TheMadHatt3r/RT-E/Hardware/Main Board Rev1.0b BOM.xlsx

PART on Schematic | Description | Digikey P/N | Qty | Cost / per | Cost 10x |  | Sub Total | Package | Pads | Pad Sum
R2,R4, R7, R8, R11, R14 | RES 4.7k 1% | RHM4.70KCFCT-ND | 6 | 0.01 |  | x10 | 0.06 | 603 | 2 | 12
R5, R6, R12, R13, R15 | RES 10k 1% | RHM10.0KCFCT-ND | 5 | 0.011 |  | x10 | 0.055 | 603 | 2 | 10
R9, R10 | RES 10k .1% TC=10ppm | 985-1381-1-ND | 2 | 0.76 |  | x1 | 1.52 | 603 | 2 | 4 | 8.3
 | RES 56k 1% | RMCF0603FT56K0CT-ND | 1 | 0.025 | 0.1 | x10 | 0.025 | 603 | 2 | 2 | 4.7 | 0.6238437545 | 0.6011534331
R16, R17, R19, R20, R21 | RES 1k 1% |  | 5 |  |  |  |  |  |  |  | 59
R1 | RES 1.0 1% | 311-1.00FRCT-ND | 1 | 0.032 |  | x10 | 0.032 | 1206 | 2 | 2
R18 | RES 200k | 311-200KGRCT-ND | 1 | 0.011 |  | x10 | 0.011 | 603 | 2 | 2
LED2 | LED GREEN | 754-1121-1-ND | 1 | 0.117 |  | x10 | 0.117 | 603 | 2 | 2
LED1 | LED Yellow | 475-1196-1-ND | 1 | 0.143 |  | x10 | 0.143 | 603 | 2 | 2 |  |  | L | W
C5, C6, C9, C10, C11, C12 | CAP 10nF 50V 10% | 1276-1009-1-ND | 6 | 0.018 |  | x10 | 0.108 | 603 | 2 | 12 |  | SOD-323 | 2.5 | 1.3 | 0.09842519685 | 0.05118110236
C2, C7, C8, C13, C14, C15, C16 | CAP 100nF 50V 10% | 1276-1936-1-ND | 7 | 0.02 |  | x10 | 0.14 | 603 | 2 | 14 |  | SOD-123 | 3.8 | 1.8 | 0.1496062992 | 0.07086614173
 | CAP 330uF 50V | 493-1343-ND |  | 0.48 | 0.34 | x10 | 0 | TH-5MM | 0 | 0 |  | SMA | 5.2 | 2.6 | 0.2047244094 | 0.1023622047
 | CAP 330uF 10V | 1189-2177-ND |  | 0.35 | 0.24 |  | 0 | TH-2.5MM
T1 | BJT (BC846B) 200x 30V | 568-1632-6-ND | 1 | 0.14 |  |  | 0.14 |  | 3 | 3
SMPS-5V | 5V SMPS | 945-1037-ND | 1 | 6.81 |  |  | 6.81 | TH | 0 | 0
 | Schottky 40V 0.5A | DB2J40700LCT-ND |  | 0.41 | 0.3 |  | 0 | SOD-323 | 2 | 0 | 4095 | 0.8058608059
D2 | TVS 28/31 | SMAJ28CALFCT-ND | 1 | 0.47 |  |  | 0.47 | SMA | 2 | 2 | 3300
D4, D5, D7, D6, D8 | 5.1V Zener | MM3Z5V1ST1GOSCT-ND | 5 | 0.13 |  | x10 | 0.65 | SOD-323 | 2 | 10
U1 | 5-> 3.3 V level shifter | 568-4215-1-ND | 1 | 0.78 |  | x1 | 0.78 | SOIC-8 | 8 | 8
SW-MM1, SW-HH1 | PUSHBUTTON - 6MM | CKN9112CT-ND | 2 | 0.2 |  | x10 | 0.4 | 6MM SMD | 4 | 8
UC (2 long sides) | Headers-F-14 | S7047-ND | 2 | 0.98 |  | x10 | 1.96 | TH | 0 | 0
TB-EXP0,TB-EXP1, TB-LCD, UC(short side) | Headers-F-5 | S7038-ND | 5 | 0.5 |  | x10 | 2.5 | TH | 0 | 0
FLOW1, FLOW2, I2C | JST-5 | 455-1707-ND | 3 | 0.26 |  | x10 | 0.78 | TH | 0 | 0
SERIAL, RESET,SPEED,LIGHT1,GPIO1,PWR | JST-2 | 455-1704-ND | 6 | 0.15 |  | x10 | 0.9 | TH | 0 | 0
SD | SD Card Slot | A101492CT-ND | 1 | 3.44 |  | 1x | 3.44 | SMD | 9 | 9
 | Comparator | ADCMP356YKSZ-REEL7CT-ND |  | 0.93 | 0.82 |  |  | SMD
BAT | BAT 3V 2032 | P657-ND | 1 | 1.06 |  | 1.06 | 1.06 | SMD | 2 | 2
 |  | Component Count | 65 |  |  |  |  |  | Pads | 104
