TheMadHatt3r/RT-E/Hardware/RT-E MainBoard Rev 1b Schematic Preliminary.pdf

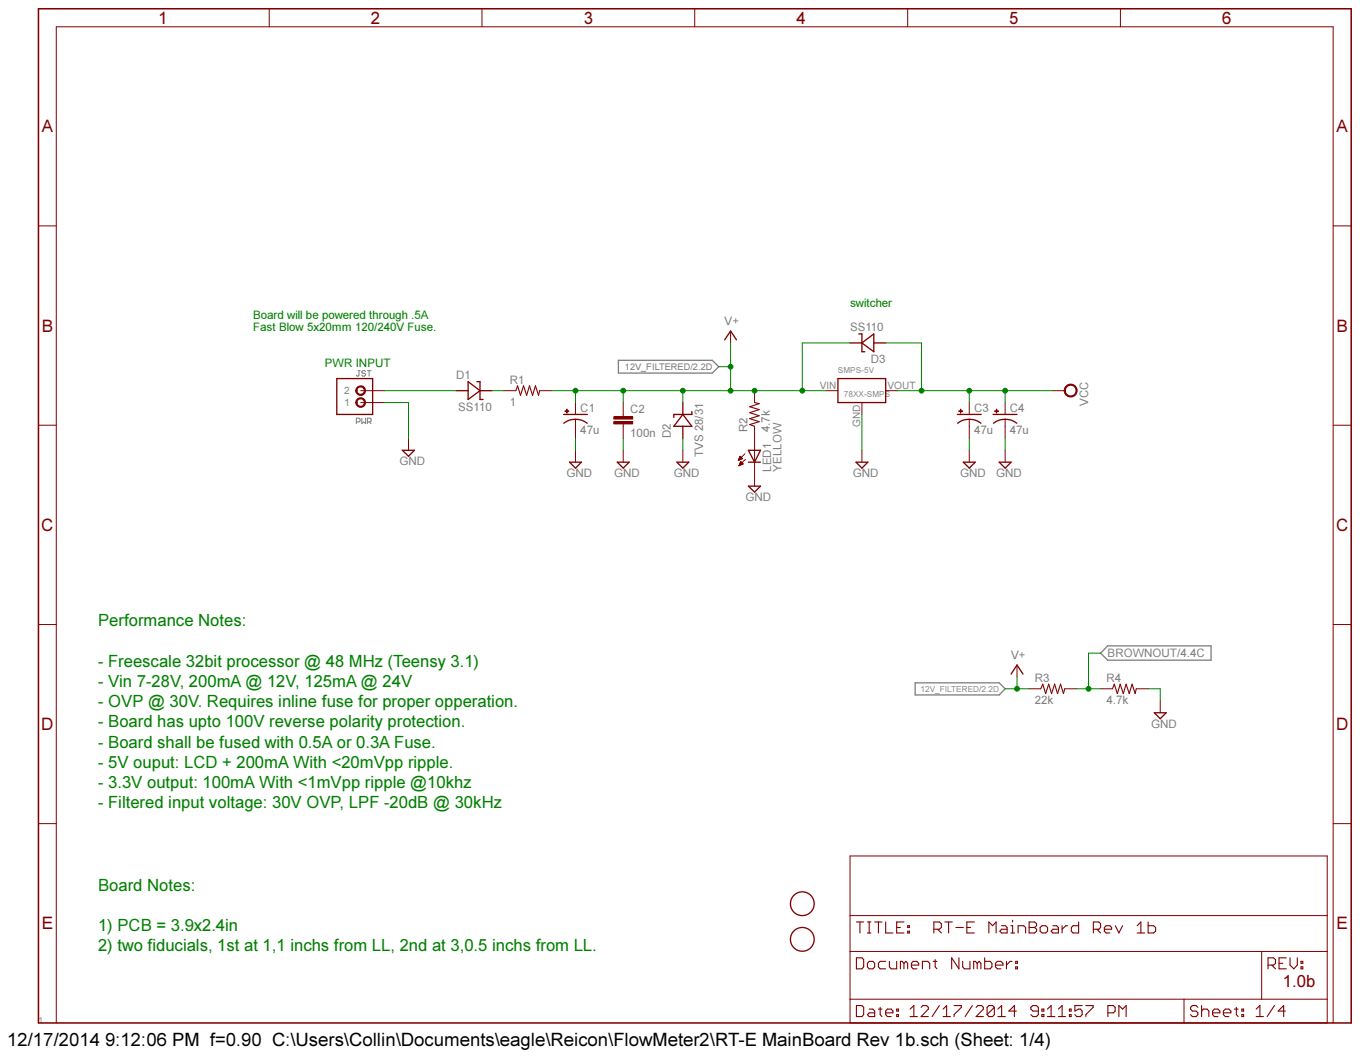
[picture p1: page 1]

Board will be powered through .5A
Fast Blow 5x20mm 120/240V Fuse.

- Freescale 32bit processor @ 48 MHz (Teensy 3.1)
- Vin 7-28V, 200mA @ 12V, 125mA @ 24V
- OVP @ 30V. Requires inline fuse for proper opperation.
- Board has upto 100V reverse polarity protection.
- Board shall be fused with 0.5A or 0.3A Fuse.
- 5V ouput: LCD + 200mA With <20mVpp ripple.
- 3.3V output: 100mA With <1mVpp ripple @10khz
- Filtered input voltage: 30V OVP, LPF -20dB @ 30kHz

1) PCB = 3.9x2.4in
2) two fiducials, 1st at 1,1 inchs from LL, 2nd at 3,0.5 inchs from LL.

12/17/2014 9:12:06 PM f=0.90 C:\Users\Collin\Documents\eagle\Reicon\FlowMeter2\RT-E MainBoard Rev 1b.sch (Sheet: 1/4)

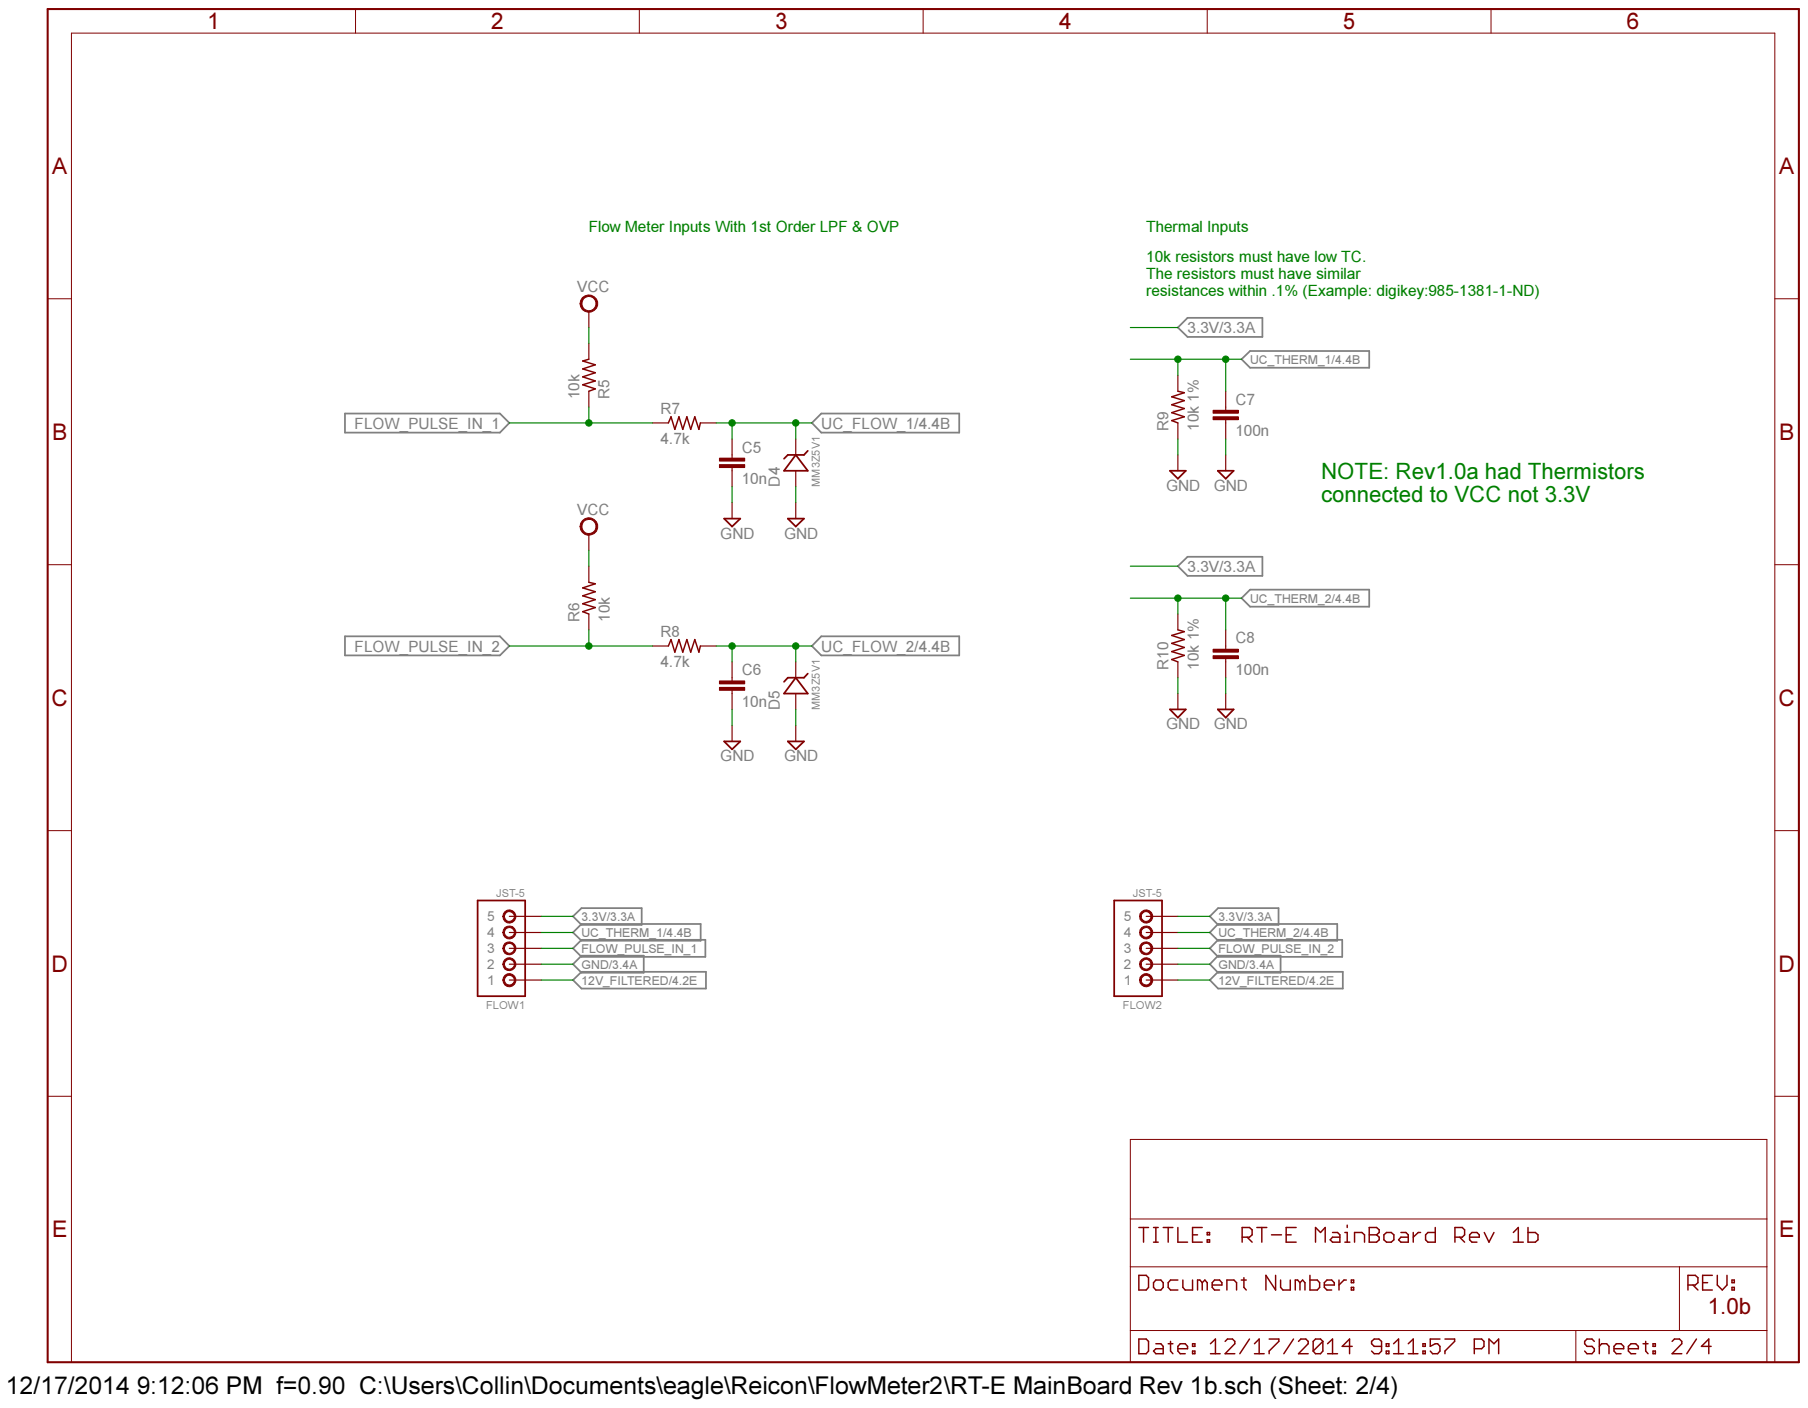
[picture p2: page 2]

10k resistors must have low TC.
The resistors must have similar
resistances within .1% (Example: digikey:985-1381-1-ND)

NOTE: Rev1.0a had Thermistors
connected to VCC not 3.3V

12/17/2014 9:12:06 PM f=0.90 C:\Users\Collin\Documents\eagle\Reicon\FlowMeter2\RT-E MainBoard Rev 1b.sch (Sheet: 2/4)

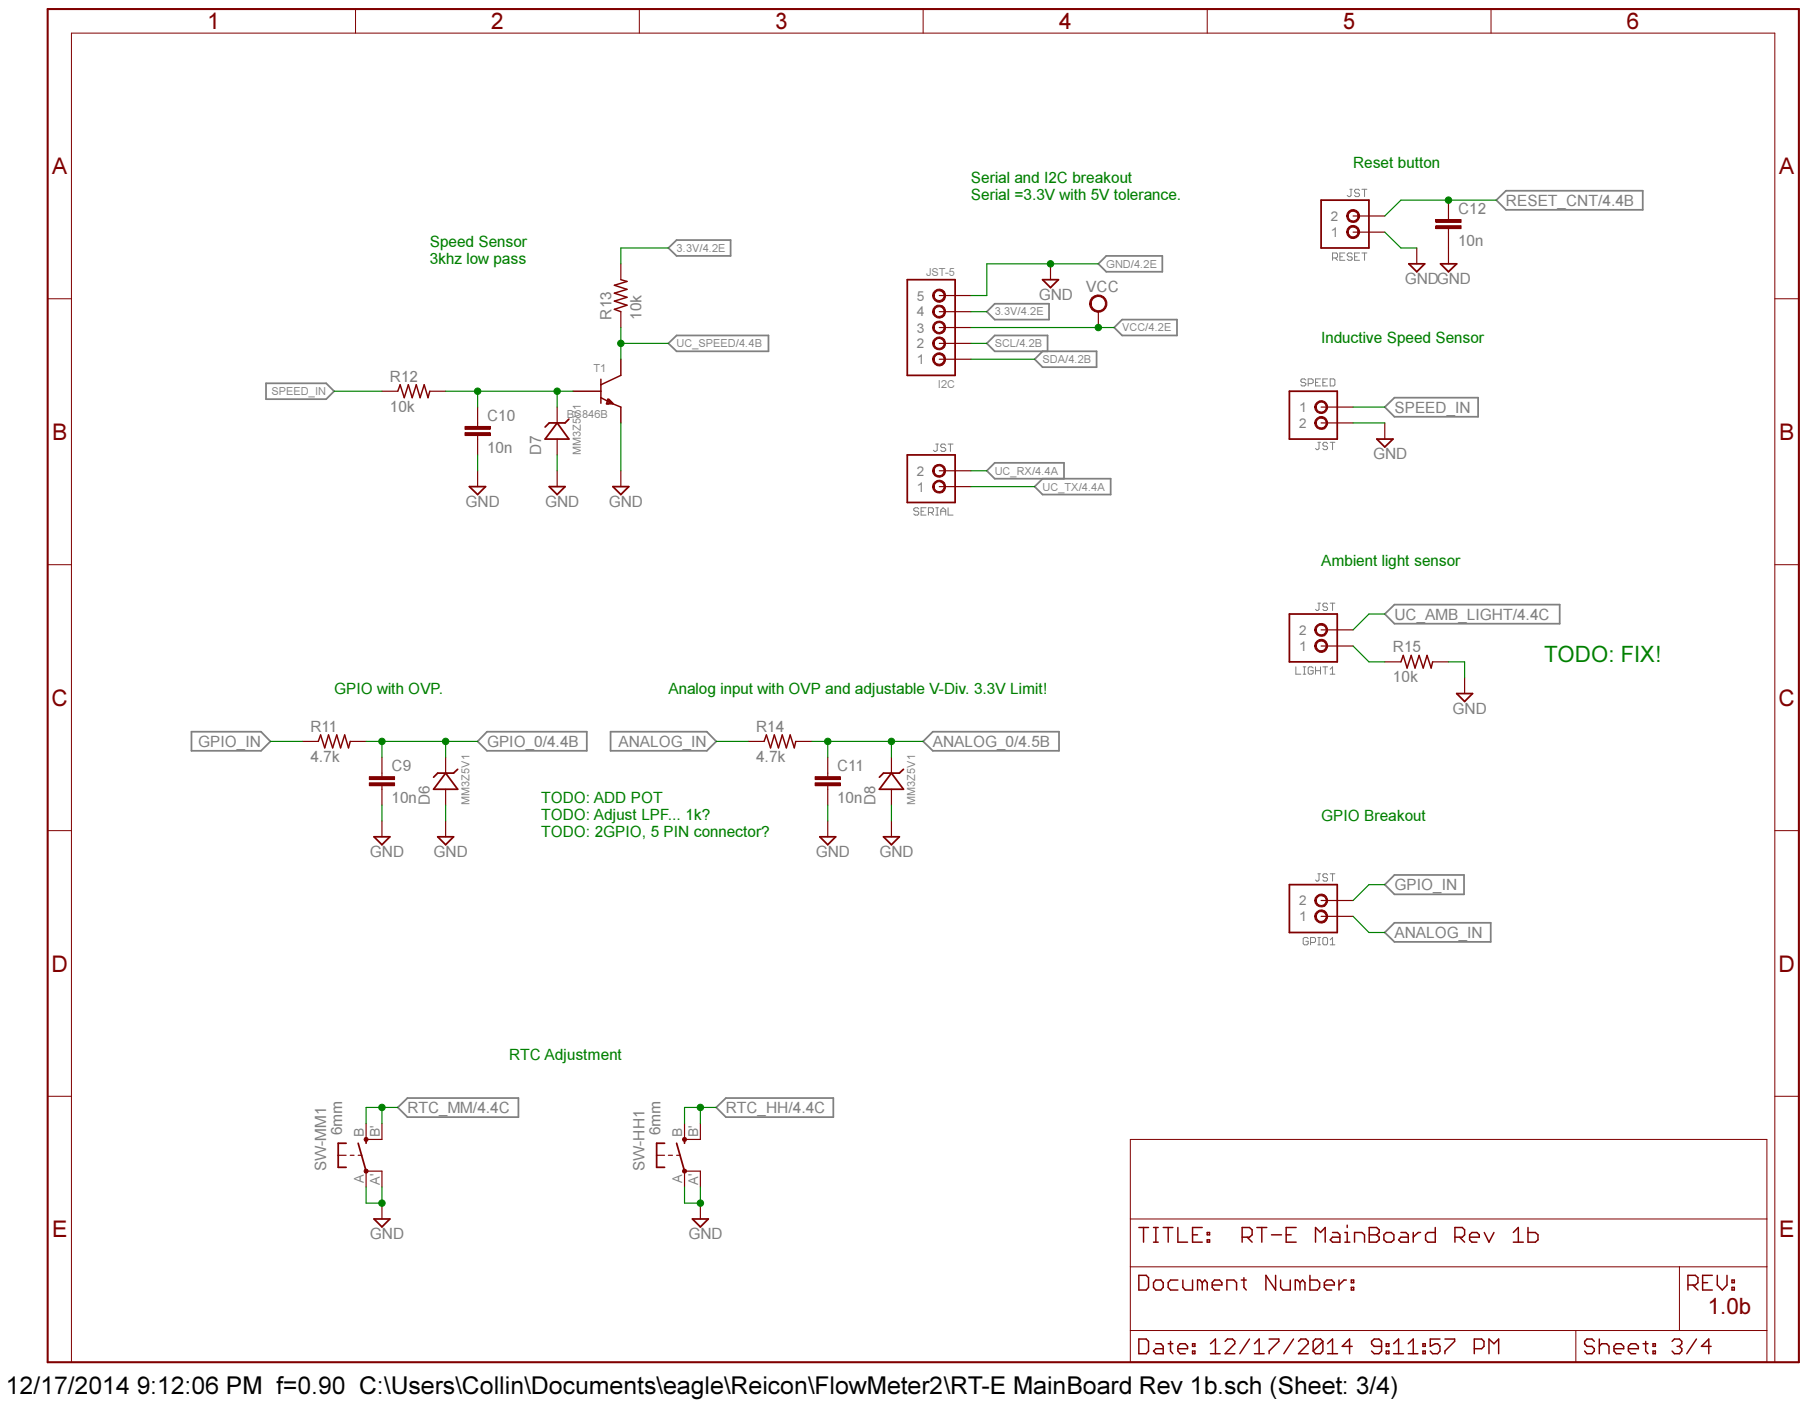
[picture p3: page 3]

12/17/2014 9:12:06 PM f=0.90 C:\Users\Collin\Documents\eagle\Reicon\FlowMeter2\RT-E MainBoard Rev 1b.sch (Sheet: 3/4)

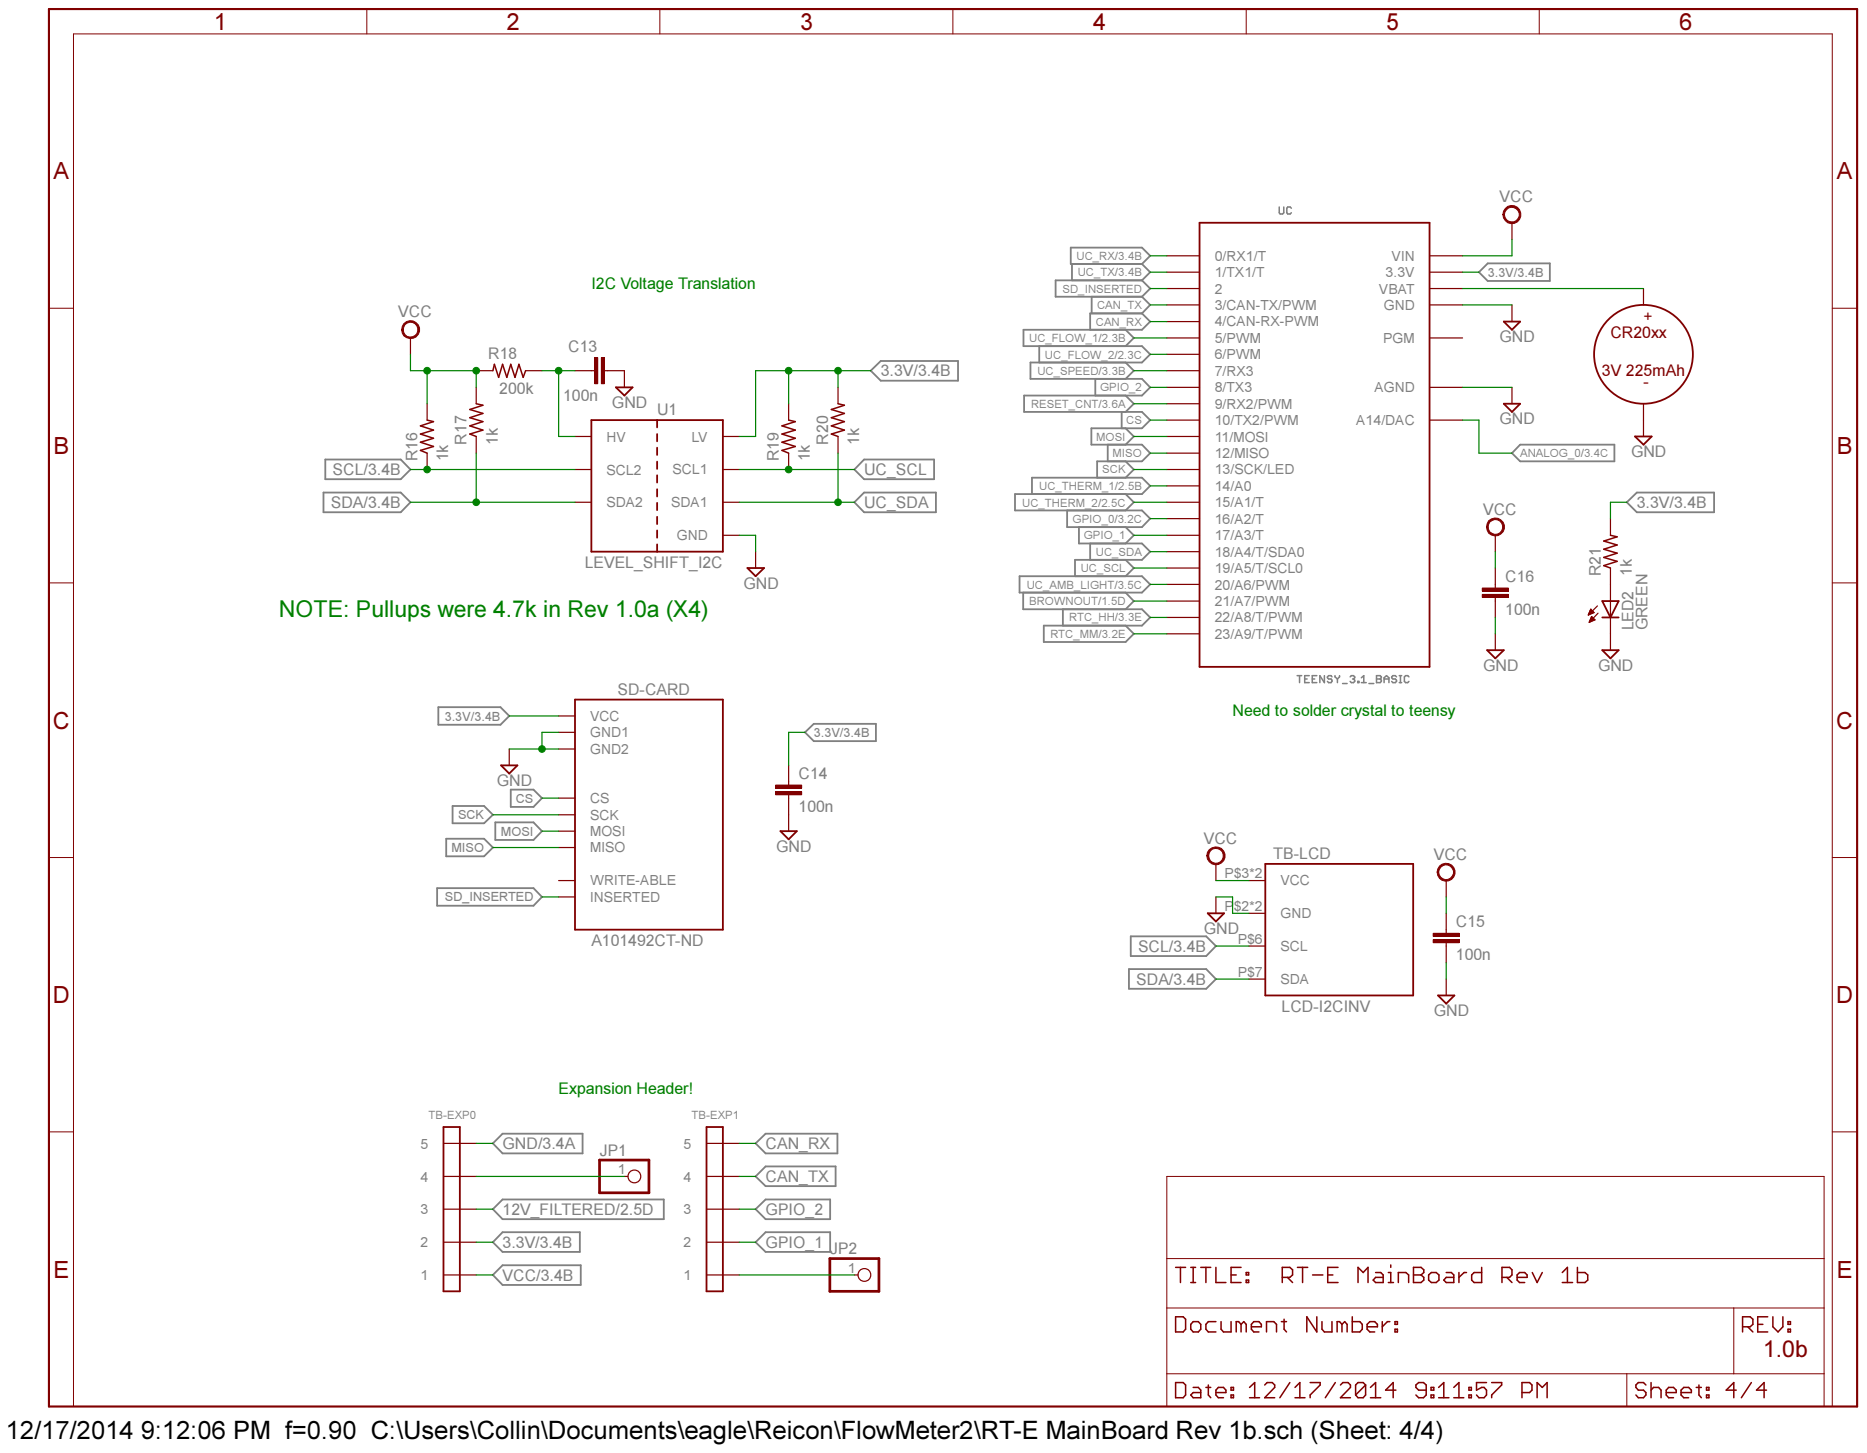
[picture p4: page 4]

NOTE: Pullups were 4.7k in Rev 1.0a (X4)

Need to solder crystal to teensy

12/17/2014 9:12:06 PM f=0.90 C:\Users\Collin\Documents\eagle\Reicon\FlowMeter2\RT-E MainBoard Rev 1b.sch (Sheet: 4/4)
