TheMadHatt3r/RT-E/Hardware/Eagle/Rev1b/RT-E MainBoard Rev 1b.brd

## EAGLE design Hardware/Eagle/Rev1b/RT-E MainBoard Rev 1b.brd (2017-10-30)

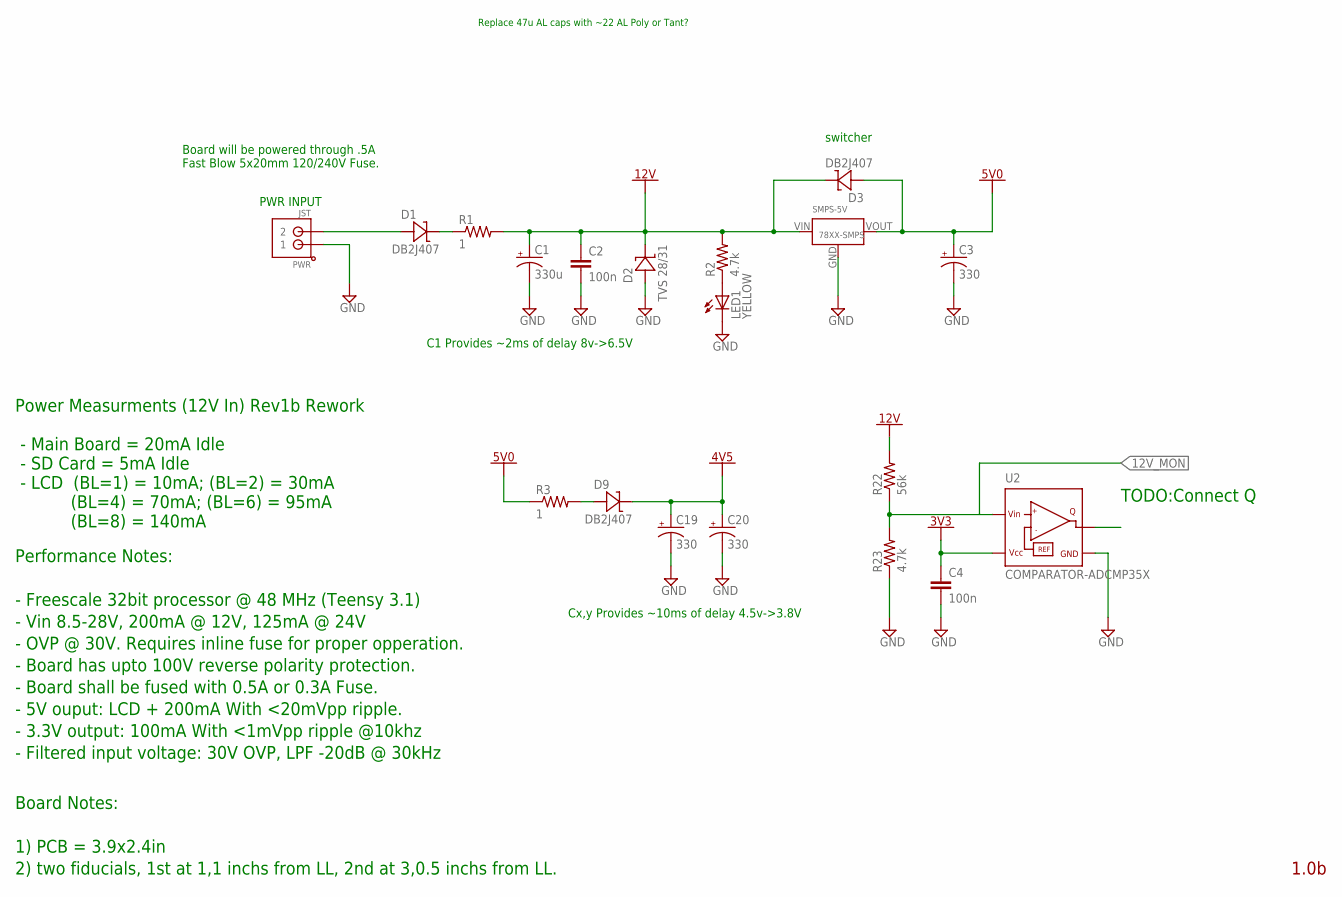
[picture p5: schematic RT-E MainBoard Rev 1b.sch, sheet 1, Power]

Parts:
C1: 330u; E5-10,5
C2, C4: 100n; C0603K
C3, C19, C20: 330; E2,5-7
D1, D3, D9: DB2J407; SOD323R_INFINEON
D2: TVS 28/31; DO-214AC(SMA)
LED1: YELLOW; CHIP-LED0603
PWR: JST; JST_B2B-PH_HEADER
R1, R3: 1; R1206
R2, R23: 4.7k; R0603
R22: 56k; R0603
SMPS-5V: 78XX-SMPS
U2: COMPARATOR-ADCMP35X; SC70-4L

Connections:
3V3: C4.1, C19.+, C20.+, D9.C, U2.5 (VCC); also elsewhere on the board
5V0: C3.+, D3.A, R3.1, SMPS-5V.VOUT; also elsewhere on the board
12V: C1.+, C2.1, D2.P$1, D3.C, R1.2, R2.2, R22.2, SMPS-5V.VIN; also elsewhere on the board
GND: C1.-, C2.2, C3.-, C4.2, C19.-, C20.-, D2.P$2, LED1.C, PWR.P1 (1), R23.1, SMPS-5V.GND, U2.3 (GND); also elsewhere on the board
unnamed: D1.C, R1.1
unnamed: LED1.A, R2.1
unnamed: R22.1, R23.2, U2.1 (VIN)
unnamed: D9.A, R3.2
unnamed: D1.A, PWR.P2 (2)

Notes on the sheet:
Board will be powered through .5A Fast Blow 5x20mm 120/240V Fuse.
switcher
Board Notes: 1) PCB = 3.9x2.4in 2) two fiducials, 1st at 1,1 inchs from LL, 2nd at 3,0.5 inchs from LL.
PWR INPUT
1.0b
Performance Notes: - Freescale 32bit processor @ 48 MHz (Teensy 3.1) - Vin 8.5-28V, 200mA @ 12V, 125mA @ 24V - OVP @ 30V. Requires inline fuse for proper opperation. - Board has upto 100V reverse polarity protection. - Board shall be fused with 0.5A or 0.3A Fuse. - 5V ouput: LCD + 200mA With <20mVp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
Power Measurments (12V In) Rev1b Rework - Main Board = 20mA Idle - SD Card = 5mA Idle - LCD (BL=1) = 10mA; (BL=2) = 30mA (BL=4) = 70mA; (BL=6) = 95mA (BL=8) = 140mA
Replace 47u AL caps with ~22 AL Poly or Tant?
C1 Provides ~2ms of delay 8v->6.5V
TODO:Connect Q
Cx,y Provides ~10ms of delay 4.5v->3.8V

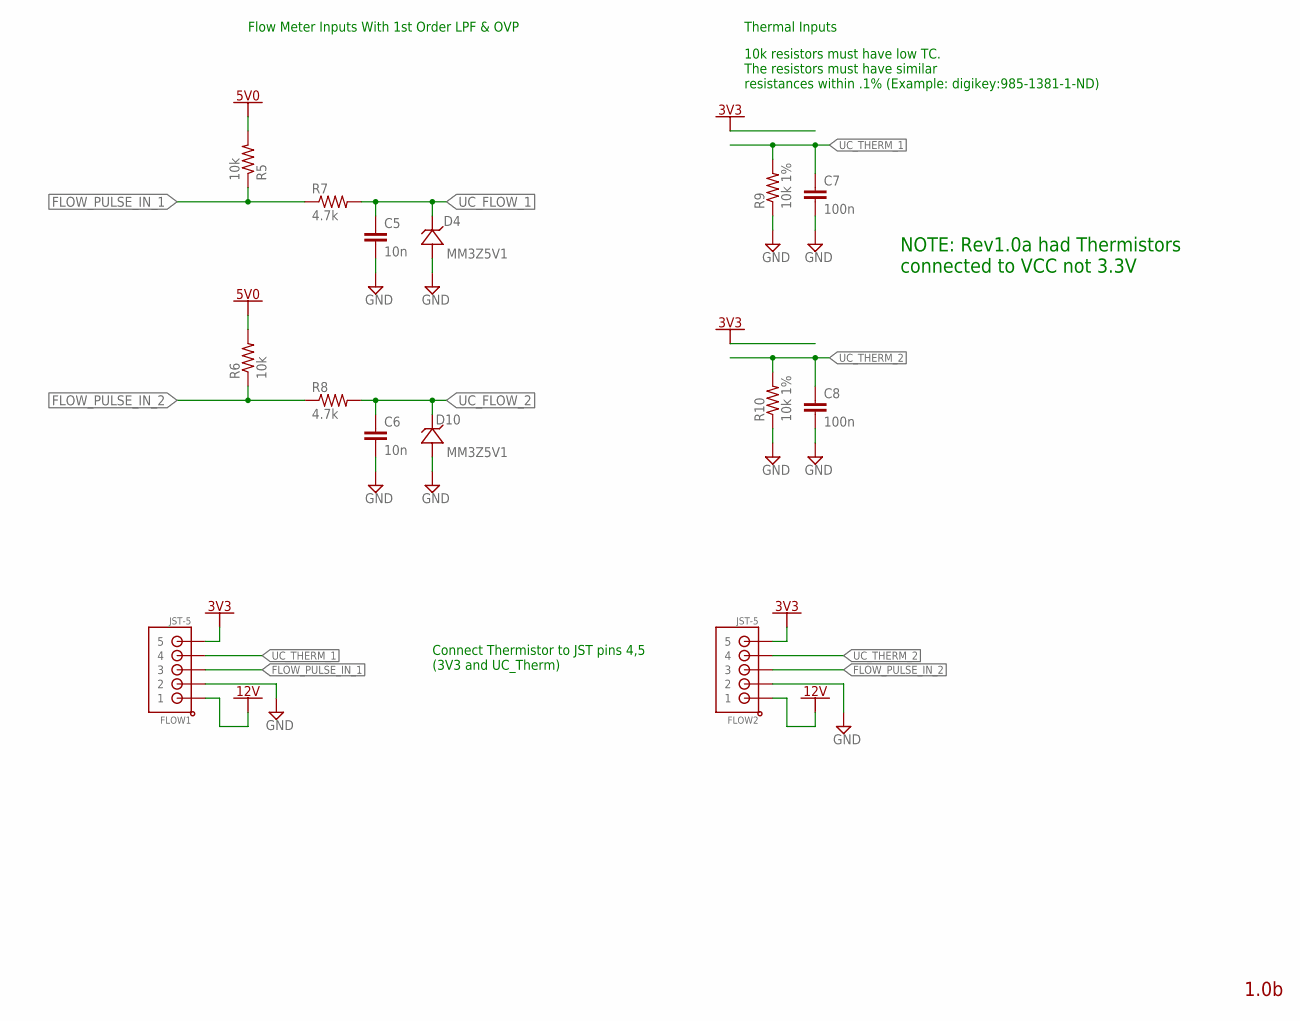
[picture p6: schematic RT-E MainBoard Rev 1b.sch, sheet 2, Flow Inputs]

Parts:
C5, C6: 10n; C0603K
C7, C8: 100n; C0603K
D4, D10: MM3Z5V1; SOD323R_INFINEON
FLOW1, FLOW2: JST-5; JST_B5B-PH_HEADER
R5, R6: 10k; R0603
R7, R8: 4.7k; R0603
R9, R10: 10k 1%; R0603

Connections:
3V3: FLOW1.P5 (5), FLOW2.P5 (5); also elsewhere on the board
5V0: R5.2, R6.2; also elsewhere on the board
12V: FLOW1.P1 (1), FLOW2.P1 (1); also elsewhere on the board
FLOW_PULSE_IN_1: FLOW1.P3 (3), R5.1, R7.1
FLOW_PULSE_IN_2: FLOW2.P3 (3), R6.1, R8.1
GND: C5.2, C6.2, C7.2, C8.2, D4.A, D10.A, FLOW1.P2 (2), FLOW2.P2 (2), R9.1, R10.1; also elsewhere on the board
UC_FLOW_1: C5.1, D4.C, R7.2; also elsewhere on the board
UC_FLOW_2: C6.1, D10.C, R8.2; also elsewhere on the board
UC_THERM_1: C7.1, FLOW1.P4 (4), R9.2; also elsewhere on the board
UC_THERM_2: C8.1, FLOW2.P4 (4), R10.2; also elsewhere on the board

Notes on the sheet:
Flow Meter Inputs With 1st Order LPF & OVP
Thermal Inputs
10k resistors must have low TC. The resistors must have similar resistances within .1% (Example: digikey:985-1381-1-ND)
1.0b
NOTE: Rev1.0a had Thermistors connected to VCC not 3.3V
Connect Thermistor to JST pins 4,5 (3V3 and UC_Therm)

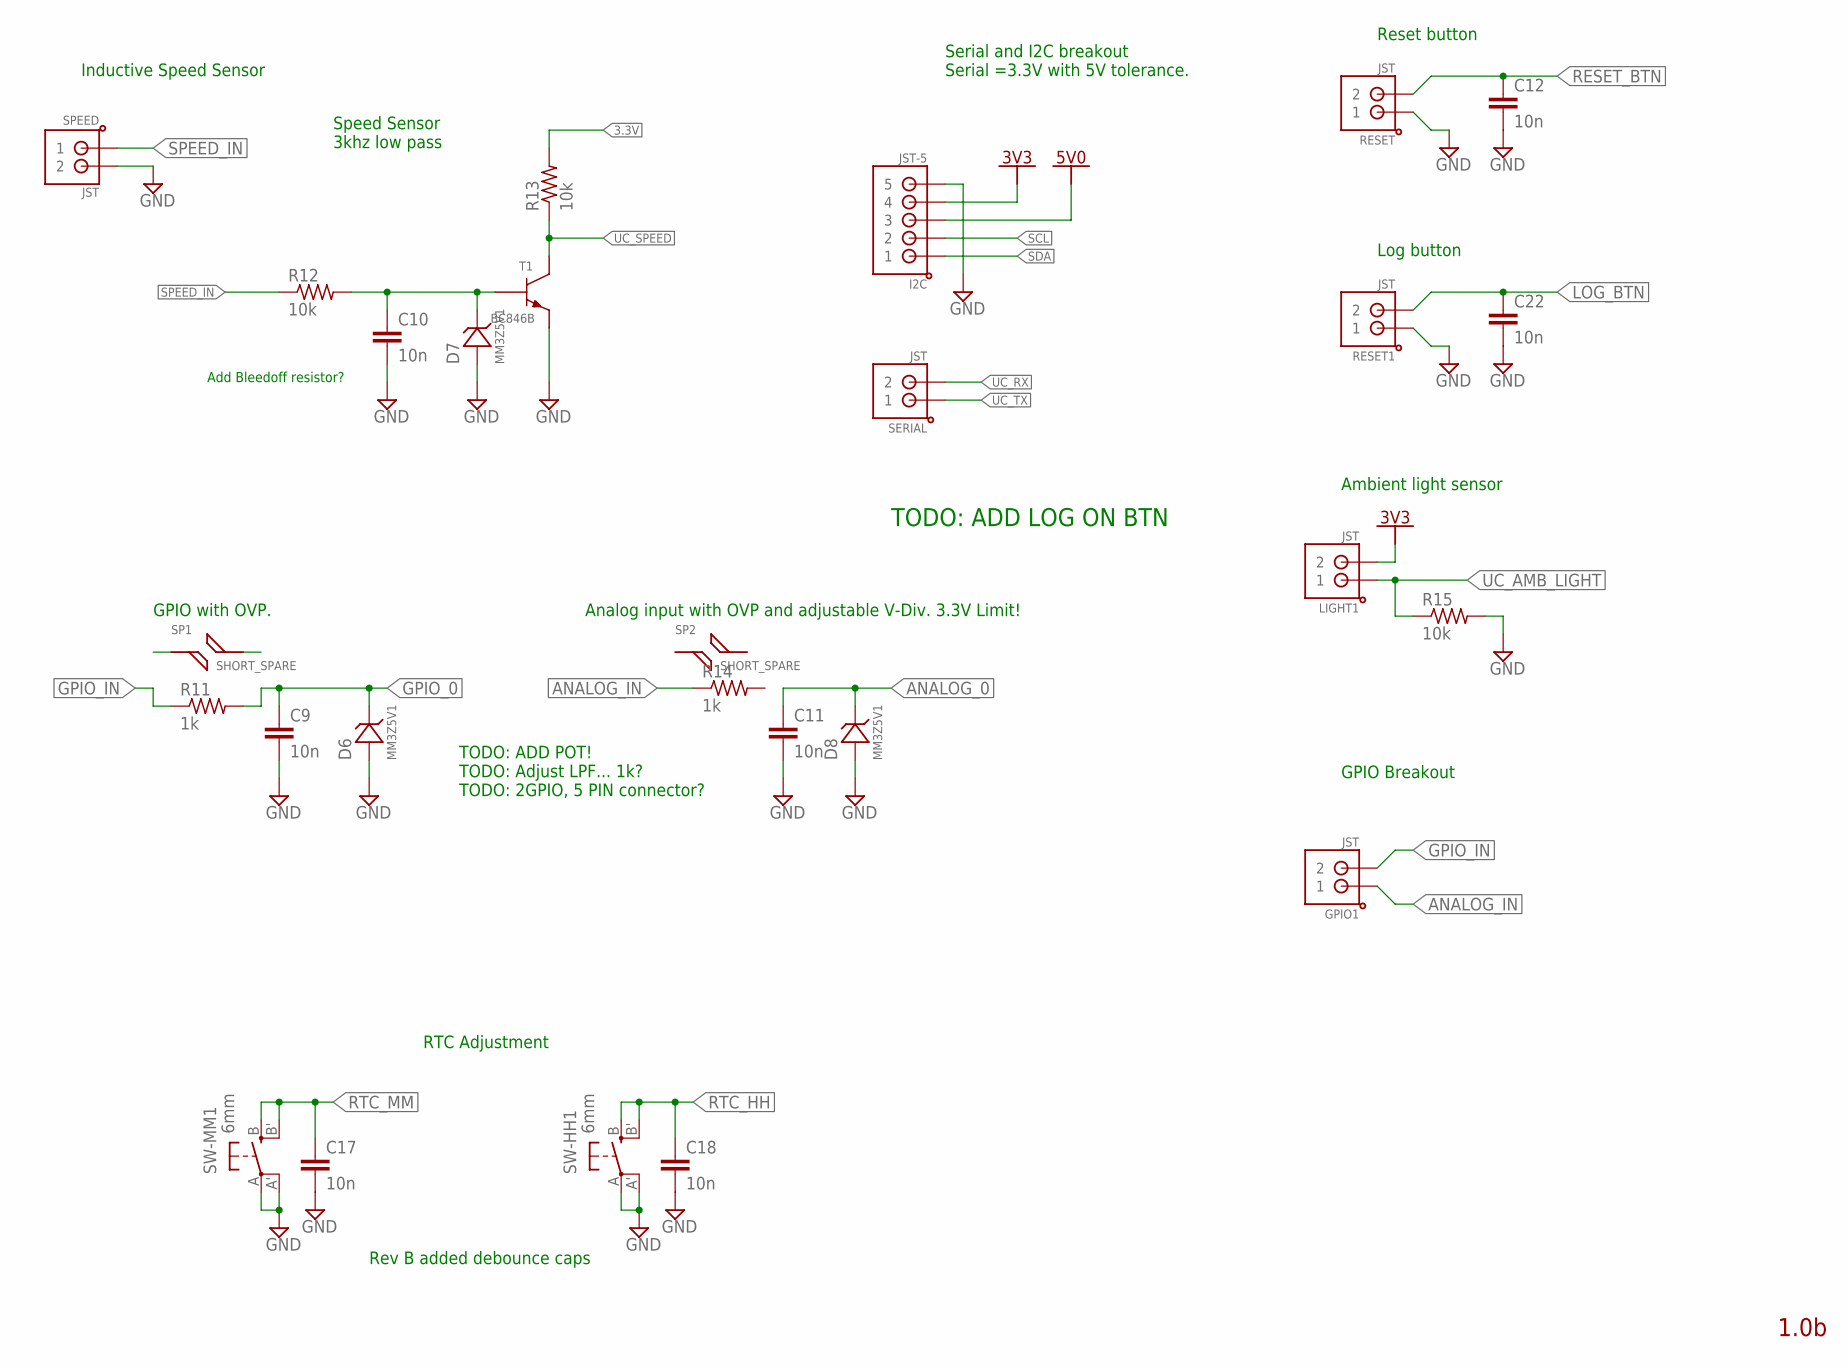
[picture p7: schematic RT-E MainBoard Rev 1b.sch, sheet 3, Other Sensors]

Parts:
C9, C10, C11, C12, C17, C18, C22: 10n; C0603K
D6, D7, D8: MM3Z5V1; SOD323-W
GPIO1: JST; JST_B2B-PH_HEADER
I2C: JST-5; JST_B5B-PH_HEADER
LIGHT1: JST; JST_B2B-PH_HEADER
R11, R14: 1k; R0603
R12, R13, R15: 10k; R0603
RESET, RESET1: JST; JST_B2B-PH_HEADER
SERIAL: JST; JST_B2B-PH_HEADER
SP1, SP2: SHORT_SPARE; SHORT_0603
SPEED: JST; JST_B2B-PH_HEADER
SW-HH1: 6mm; EVQ-Q2
SW-MM1: 6mm; EVQ-Q2
T1: BC846B; BJT-BC846

Connections:
3.3V: R13.2; also elsewhere on the board
3V3: I2C.P4 (4), LIGHT1.P2 (2); also elsewhere on the board
5V0: I2C.P3 (3); also elsewhere on the board
ANALOG_0: C11.1, D8.C; also elsewhere on the board
ANALOG_IN: GPIO1.P1 (1), R14.1
GND: C9.2, C10.2, C11.2, C12.2, C17.2, C18.2, C22.2, D6.A, D7.A, D8.A, I2C.P5 (5), R15.2, RESET.P1 (1), RESET1.P1 (1), SPEED.P2 (2), SW-HH1.A, SW-HH1.A' (P1), SW-MM1.A, SW-MM1.A' (P1), T1.E; also elsewhere on the board
GPIO_0: C9.1, D6.C, R11.2; also elsewhere on the board
GPIO_IN: GPIO1.P2 (2), R11.1
LOG_BTN: C22.1, RESET1.P2 (2); also elsewhere on the board
unnamed: C10.1, D7.C, R12.2, T1.B
RESET_BTN: C12.1, RESET.P2 (2); also elsewhere on the board
RTC_HH: C18.1, SW-HH1.B (S), SW-HH1.B' (S1); also elsewhere on the board
RTC_MM: C17.1, SW-MM1.B (S), SW-MM1.B' (S1); also elsewhere on the board
SCL: I2C.P2 (2); also elsewhere on the board
SDA: I2C.P1 (1); also elsewhere on the board
SPEED_IN: R12.1, SPEED.P1 (1)
UC_AMB_LIGHT: LIGHT1.P1 (1), R15.1; also elsewhere on the board
UC_RX: SERIAL.P2 (2); also elsewhere on the board
UC_SPEED: R13.1, T1.C; also elsewhere on the board
UC_TX: SERIAL.P1 (1); also elsewhere on the board

Notes on the sheet:
Speed Sensor 3khz low pass
Reset button
RTC Adjustment
GPIO with OVP.
Analog input with OVP and adjustable V-Div. 3.3V Limit!
TODO: ADD POT! TODO: Adjust LPF... 1k? TODO: 2GPIO, 5 PIN connector?
Serial and I2C breakout Serial =3.3V with 5V tolerance.
GPIO Breakout
Ambient light sensor
Inductive Speed Sensor
1.0b
Rev B added debounce caps
Add Bleedoff resistor?
TODO: ADD LOG ON BTN
Log button

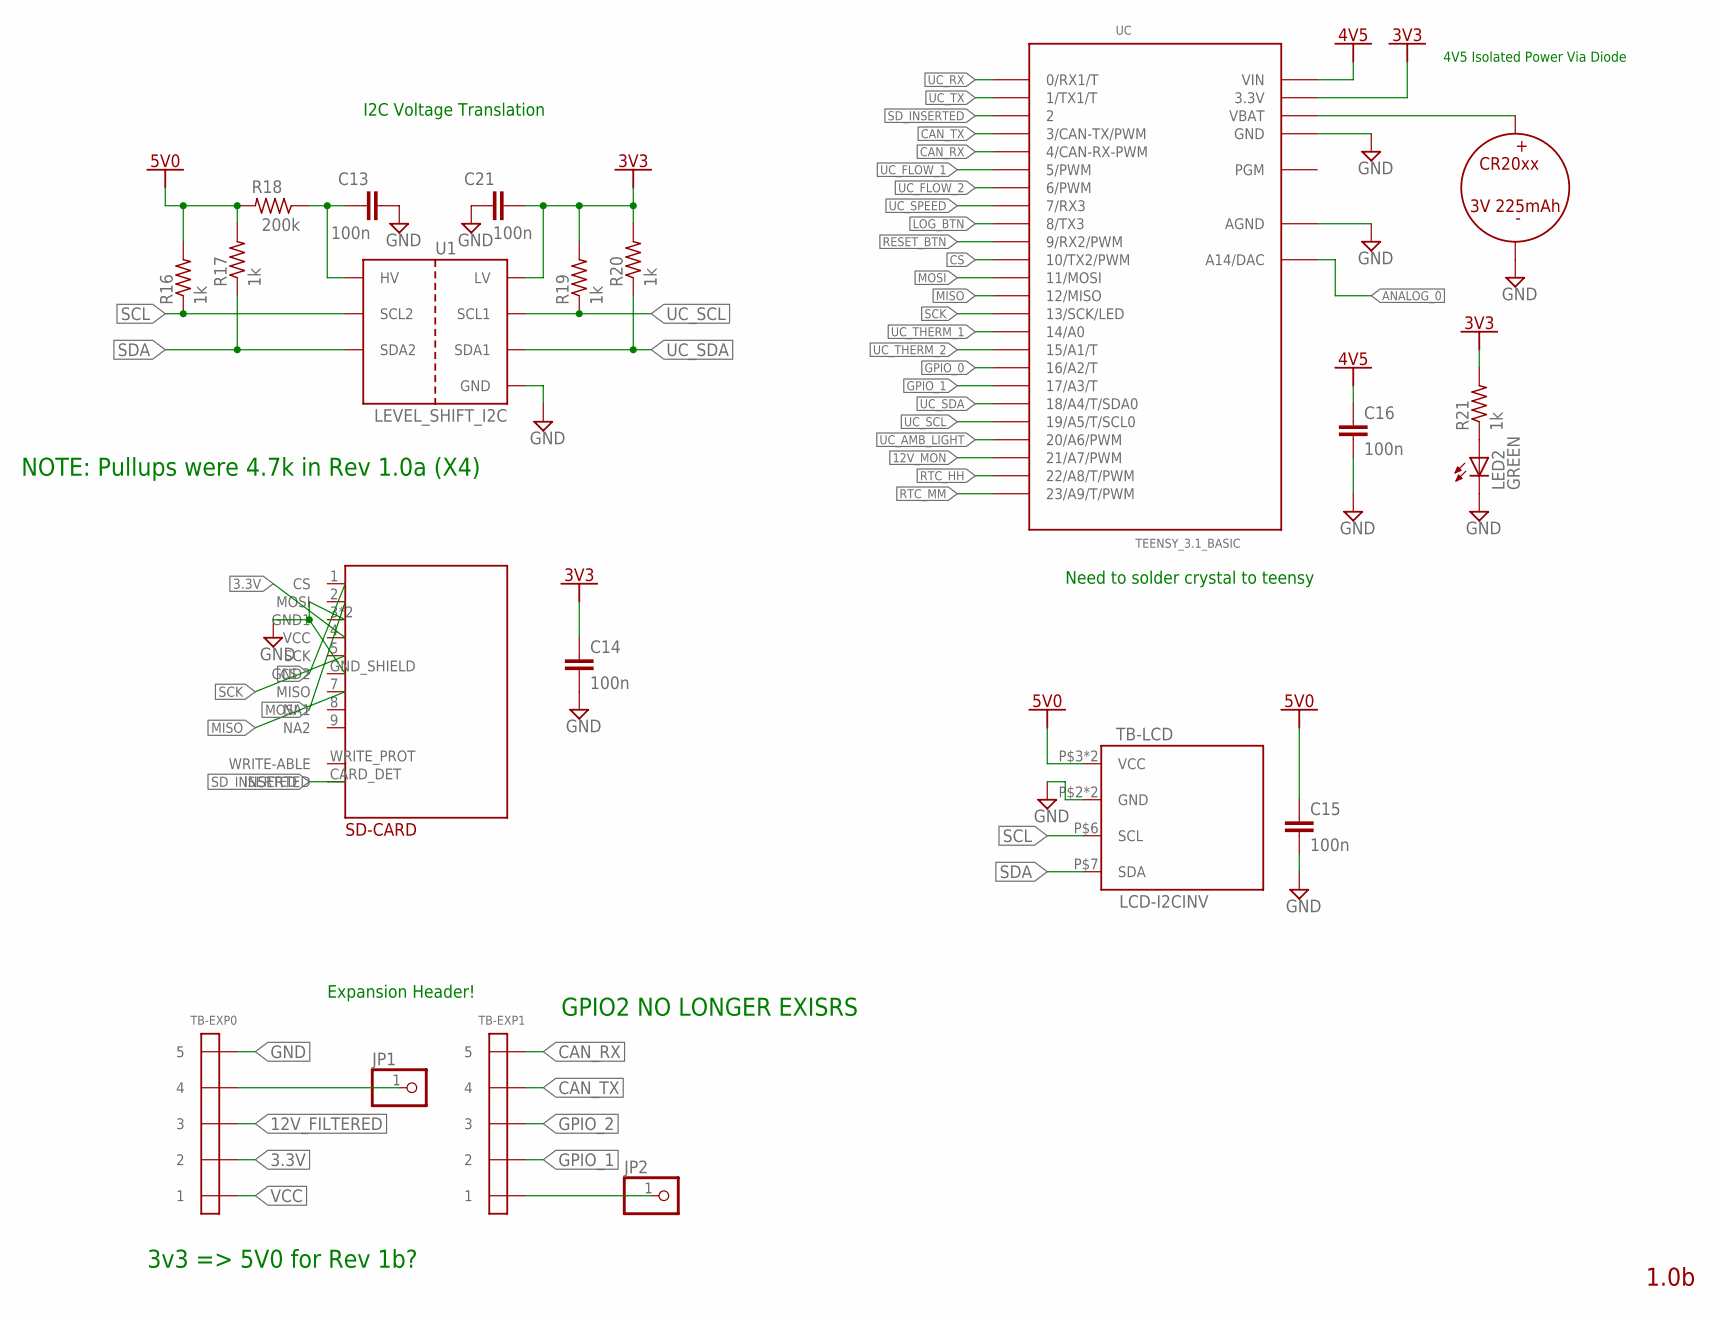
[picture p8: schematic RT-E MainBoard Rev 1b.sch, sheet 4]

Parts:
BAT: 3V_LITH_20MM; COIN_CELL_HORZ_20MM
C13, C14, C15, C16, C21: 100n; C0603K
JP1, JP2: PINHD-1X1CB; 1X01-CLEANBIG
LED2: GREEN; CHIP-LED0603
R16, R17, R19, R20, R21: 1k; R0603
R18: 200k; R0603
SD-CARD: A101492CT-ND; SD-CARD-1
TB-EXP0, TB-EXP1: EXPANSION_HEADER_5; HEADER_1X5_2.54MM
TB-LCD: LCD-I2CINV; LCD_I2C_INV
U1: LEVEL_SHIFT_I2C; SO08
UC: TEENSY_3.1_BASIC

Connections:
3.3V: SD-CARD.4 (VCC), TB-EXP0.P$2 (2); also elsewhere on the board
3V3: C14.1, C21.2, R19.2, R20.2, R21.2, U1.2 (LV), UC.3.3V, UC.3.3V1 (3.3V); also elsewhere on the board
4V5: C16.1, UC.VIN
5V0: C15.1, R16.2, R17.2, R18.2, TB-LCD.P$3 (VCC), TB-LCD.P$9 (VCC); also elsewhere on the board
12V_FILTERED: TB-EXP0.P$3 (3)
12V_MON: UC.21/A7 (21/A7/PWM)
ANALOG_0: UC.A14 (A14/DAC); also elsewhere on the board
CAN_RX: TB-EXP1.P$5 (5), UC.4 (4/CAN-RX-PWM)
CAN_TX: TB-EXP1.P$4 (4), UC.3 (3/CAN-TX/PWM)
CS: SD-CARD.1 (CS), UC.10 (10/TX2/PWM)
GND: BAT.NEG (-), C13.2, C14.2, C15.2, C16.2, C21.1, LED2.C, SD-CARD.3 (GND1), SD-CARD.6 (GND1), SD-CARD.GND_SHIELD (GND2), TB-EXP0.P$5 (5), TB-LCD.P$2 (GND), TB-LCD.P$8 (GND), U1.1 (GND), UC.AGND, UC.GND, UC.GND1 (GND); also elsewhere on the board
GPIO_0: UC.16/A2 (16/A2/T); also elsewhere on the board
GPIO_1: TB-EXP1.P$2 (2), UC.17/A3 (17/A3/T)
GPIO_2: TB-EXP1.P$3 (3)
LOG_BTN: UC.8 (8/TX3); also elsewhere on the board
MISO: SD-CARD.7 (MISO), UC.12 (12/MISO)
MOSI: SD-CARD.2 (MOSI), UC.11 (11/MOSI)
unnamed: LED2.A, R21.1
unnamed: JP1.1, TB-EXP0.P$4 (4)
unnamed: C13.1, R18.1, U1.7 (HV), U1.8 (HV)
unnamed: BAT.POS (+), UC.VBAT
unnamed: JP2.1, TB-EXP1.P$1 (1)
RESET_BTN: UC.9 (9/RX2/PWM); also elsewhere on the board
RTC_HH: UC.22/A8 (22/A8/T/PWM); also elsewhere on the board
RTC_MM: UC.23/A9 (23/A9/T/PWM); also elsewhere on the board
SCK: SD-CARD.5 (SCK), UC.13 (13/SCK/LED)
SCL: R16.1, TB-LCD.P$6 (SCL), U1.6 (SCL2); also elsewhere on the board
SDA: R17.1, TB-LCD.P$7 (SDA), U1.5 (SDA2); also elsewhere on the board
SD_INSERTED: SD-CARD.CARD_DET (INSERTED), UC.2
UC_AMB_LIGHT: UC.20/A6 (20/A6/PWM); also elsewhere on the board
UC_FLOW_1: UC.5 (5/PWM); also elsewhere on the board
UC_FLOW_2: UC.6 (6/PWM); also elsewhere on the board
UC_RX: UC.0 (0/RX1/T); also elsewhere on the board
UC_SCL: R19.1, U1.3 (SCL1), UC.19/A5 (19/A5/T/SCL0)
UC_SDA: R20.1, U1.4 (SDA1), UC.18/A4 (18/A4/T/SDA0)
UC_SPEED: UC.7 (7/RX3); also elsewhere on the board
UC_THERM_1: UC.14/A0; also elsewhere on the board
UC_THERM_2: UC.15/A1 (15/A1/T); also elsewhere on the board
UC_TX: UC.1 (1/TX1/T); also elsewhere on the board
VCC: TB-EXP0.P$1 (1)

Notes on the sheet:
I2C Voltage Translation
Need to solder crystal to teensy
Expansion Header!
1.0b
NOTE: Pullups were 4.7k in Rev 1.0a (X4)
3v3 => 5V0 for Rev 1b?
4V5 Isolated Power Via Diode
GPIO2 NO LONGER EXISRS

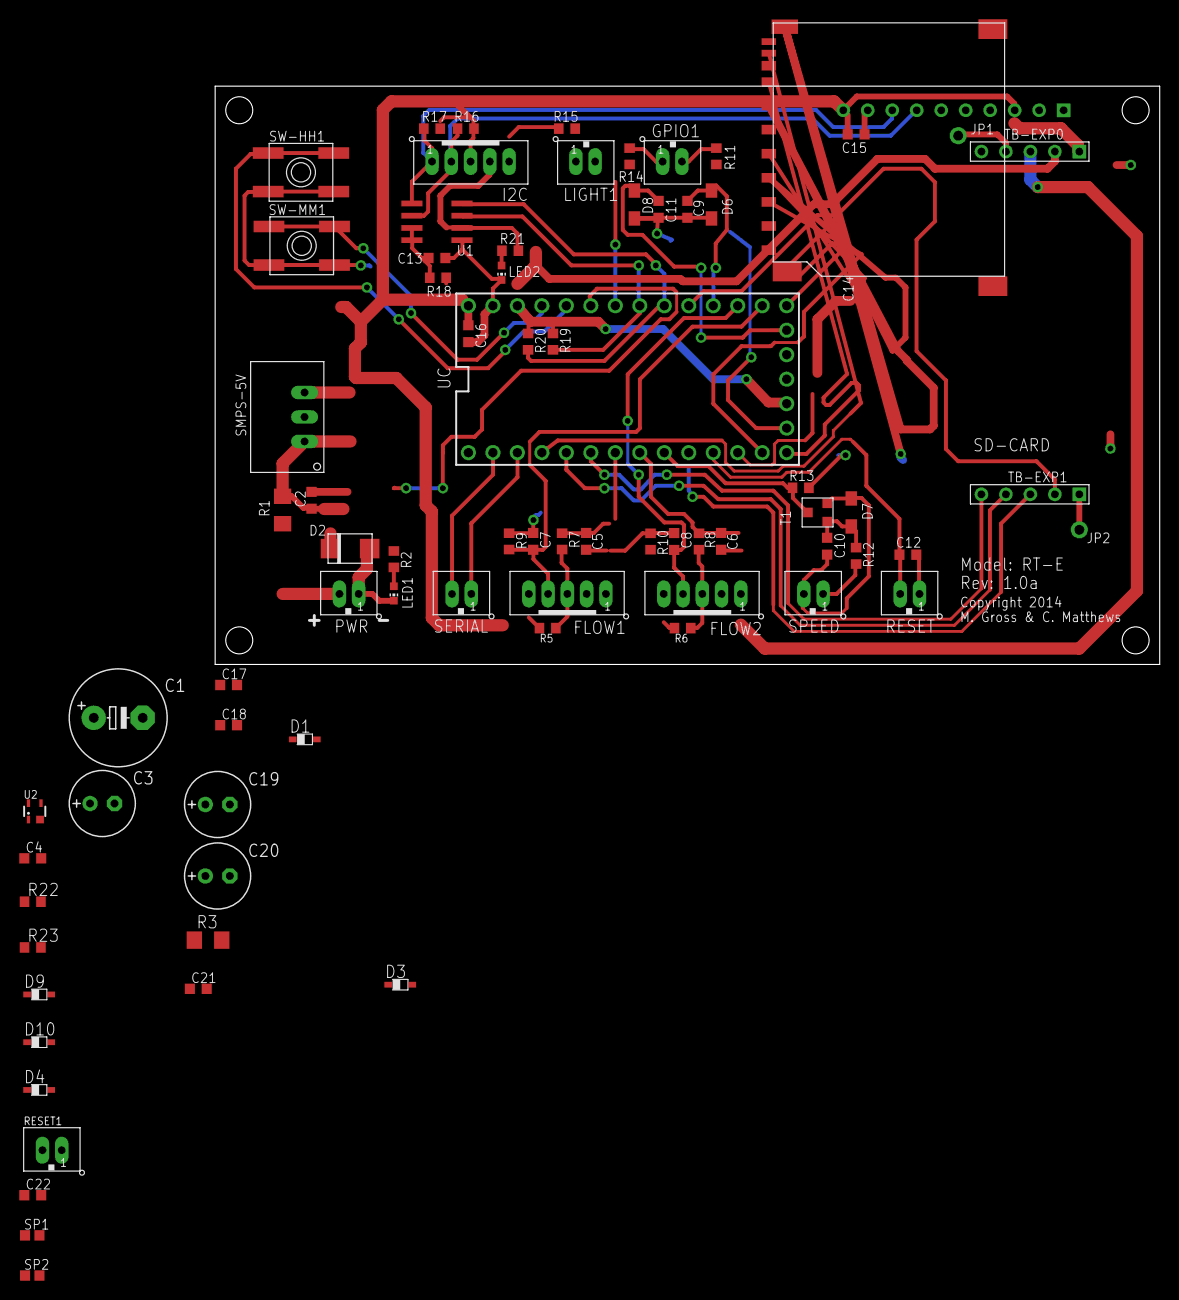
[picture p9: board RT-E MainBoard Rev 1b.brd from above]

Board: 2 copper layers, 98.0 x 60.0 mm, 81 parts (1 on the bottom side), 48 nets.
