TheMadHatt3r/RT-E/(notices)

Notices in the files:
Hardware/Eagle/Rev1b/RT-E MainBoard Rev 1b.brd:
Copyright 2014
